jwnelson/HABEXpico/Hardware/HABEXpico8-A/HABEXpico8_BOM.xlsx

Qty | Value | Device | Package | Parts | Description | MANUFACTURER_PART_NUMBER | Digikey PN
1 | 22pF | CAPACITOR_0603_L | RESC0603_L | C0 | Generic chip capacitor | GRM1885C1H220JA01D | 490-1411-1-ND
1 | TV1030-3R0106-R | TV1030-3R0106-R | 5.0MM-SUPERCAP | C1 | 10F Supercapacitor | TV1030-3R0106-R | 283-4668-ND
9 | 0.1uF | 0.1UF-0603-25V-5% | 603 | C4, C8, C11, C12, C13, C16, C23, C24, C27 | 0.1¬µF ceramic capacitors | GCM188R71C104KA37D | 490-4774-1-ND
3 | 1.0uF | 1.0UF-0603-16V-10% | 603 | C14, C15, C19 | 1¬µF ceramic capacitors | CGA3E1X7R1C105K080AC | 445-12539-1-ND
1 | 2.2uF | 2.2UF-0603-10V-20% | 603 | C2 | 2.2¬µF ceramic capacitors | CL10B225KP8NNNC | 1276-1134-1-ND
2 | 10nF | 10NF-0603-50V-10% | 603 | C20, C26 | 0.01uF/10nF/10,000pF ceramic capacitors | GCM188R72A103KA37D | 490-4781-1-ND
2 | 10uF | 10UF-0603-6.3V-20% | 603 | C21, C25 | 10.0¬µF ceramic capacitors | C1608X7S0J106M080AC | 445-9104-1-ND
1 | 10uF | 10UF-0805-10V-10% | 805 | C22 | 10.0¬µF ceramic capacitors | GRM21BC71E106KE11L | 490-10496-1-ND
2 | 10pF | 10PF-0603-50V-5% | 603 | C28, C29 | 10pF ceramic capacitors | 06035A100JAT2A | 478-1163-1-ND
1 | 4.7uF | 4.7UF0603 | 603 | C3 | 4.7¬µF ceramic capacitors | C1608X7S1A475K080AC | 445-14258-1-ND
3 | 22uF | 22UF-0805-6.3V-20% | 805 | C5, C6, C7 | 22¬µF ceramic capacitors | GRM21BD71A226ME44L | 490-9959-1-ND
4 | 6pF | C-EUC0603 | 603 | C9, C10, C17, C18 | CAPACITOR, European symbol | GCM1885C1H6R0DA16D | 490-13303-1-ND
1 | 4.7pF | CAPACITOR_0603_L | 603 | CM | Generic chip capacitor | 06035A4R7BAT2A | 478-10076-1-ND
1 | 7.5pF | CAPACITOR_0603_L | 603 | CM2 | Generic chip capacitor | 06032U7R5CAT2A | 478-3841-1-ND
2 | USBLC6-2SC6 | USBLC6-2SC6 | SOT23-6L | CR1, CR2 | Zener Diode | USBLC6-2SC6 | 497-5235-1-ND
1 | 10pF | CAPACITOR_0603_L | 603 | CX | Generic chip capacitor | GQM1875C2E100JB12D | 490-6086-1-ND
1 | ZLLS400 | ZLLS400 | SOD-323 | D1 | SCHOTTKY DIODE, ZLLS400 | ZLLS400TA | ZLLS400TACT-ND
1 |  | SLVU2.8HTG | SOT-23 | D2 | TVS Diode | SLVU2.8HTG | F4207CT-ND
1 | RED | LED-RED0603 | LED-0603 | D3 | Red SMD LED | LTST-C191KRKT | 160-1447-1-ND
1 | GREEN | LED-GREEN0603 | LED-0603 | D4 | Green SMD LED | LTST-C191KGKT | 160-1446-1-ND
1 |  | LT1763CS8-3.3 | SOIC8 | IC1 | 500mA, Low Noise, LDO Micropower Regulators | LT1129CS8-3.3#PBF | LT1129CS8-3.3#PBF-ND
1 |  | CONN_05X2SHD | 2X5-SHROUDED | J1 | Multi connection point. Often used as Generic Header-pin footprint for 0.1 inch spaced/style header connections | 702461004 | WM3478-ND
1 |  | USB_AB_SMT | USB-AB-MICRO-SMD | J2 | USB Type AB Micro Connector | 10104111-0001LF | 609-4053-1-ND
7 |  | JUMPER-2PTH | 1X02 | JP1, JP2, JP3, JP10, JP11, JP12, JP13 | Jumper | 77311-118-02LF | 609-4434-ND
12 |  | JUMPER-3PTH | 1X03 | JP6, JP7, JP8, JP9, JP14, JP15, JP16, JP17, JP18, JP19, JP20, JP21 |  | 68000-103HLF | 609-3461-ND
1 | 56nH | INDUCTOR_0603_L | RESC0603_L | L0 | Generic chip inductor | B82496C3560J000 | 495-2033-1-ND
1 | 10uH | INDUCTOR-1210 | 1210-INDUCTOR | L1 | Inductor, 1210 Package | 1277AS-H-100M=P2 | 490-10589-1-ND
1 | 33nH/¬±5%/500mA | INDUCTOR-0603-33NH | 603 | L2 | Inductors | PE-0603CD330JTT | 553-1023-2-ND
1 | 470nH | INDUCTOR_0603_L | RESC0603_L | LC | Generic chip inductor | MLZ1608DR47DT000 | 445-6388-1-ND
1 | 12nH | INDUCTOR_0603_L | RESC0603_L | LM | Generic chip inductor | HK160812NJ-T | 587-1546-1-ND
1 | 140nH | INDUCTOR_0603_L | RESC0603_L | LX | Generic chip inductor | HK1608R15J-T | 587-1559-1-ND
3 |  | CONN_08";1X08" | 1X08 | J3, J4, J5 | Genertic header pins | 68001-108HLF | 609-3273-ND
1 | 2.5A/30V | MOSFET-PCHANNELDMG2307L | SOT23-3 | Q1 | Generic PMOSFET | SSM3J334R,LF | SSM3J334RLFCT-ND
5 | 1M | RESISTOR0603 | 603 | R1, R2, R3, R9, R10 | Generic Resistor Package | RC0603FR-071ML | 311-1.00MHRCT-ND
1 | 10 | 10OHM-1206-1/4W-1% | 1206 | R11 | 10Œ© resistor | RT1206BRD0710RL | YAG2330CT-ND
2 | 5.1k | RESISTOR0604 | 603 | R14, R15 | Generic Resistor Package | RR0816P-512-D | RR08P5.1KDCT-ND
2 | 300 | 300OHM-0603-1/10W-1% | 603 | R17, R18 | 300Œ© resistor | RR0816P-301-D | RR08P300DCT-ND
3 | 10k | 10KOHM-0603-1/10W-1% | 603 | R4, R12, R19 | 10kŒ© resistor | RR0816P-103-D | RR08P10.0KDCT-ND
1 | 100 | 100OHM-0603-1/10W-1% | 603 | R5 | 100Œ© resistor | RR0816P-101-D | RR08P100DCT-ND
4 | 27 | 27OHM-0603-1/10W-1% | 603 | R6, R7, R13, R16 | 27Œ© resistor | RR0816Q-270-D | RR08Q27DCT-ND
3 | 100k | 100KOHM-0603-1/10W-1% | 603 | R8, R20, R21 | 100kŒ© resistor | RR0816P-104-D | RR08P100KDCT-ND
2 | KXOB22-04X3 | KXOB22-04X3 | KX0B22 | SC1, SC2 | IXYS Solar Cell | KXOB22-04X3F | KXOB22-04X3F-ND
2 | SKQGADE010 | SMD-BUTTON(4P-5.2X5.2X1.5MM-SKQGADE010)-SKQGADE010 | SW4-SMD-5.2X5.2X1.5MM | SW1, SW2 | 311020017 | RS-187R05A2-DS MT RT | CKN10361CT-ND
1 | LTC3106 | LTC3106 | UDC20QFN | U1 | LTC Series | LTC3106EUDC#PBF | LTC3106EUDC#PBF-ND
1 | EVA-8MQ | EVA-8MQ | EVA-8MQ | U2 | u-blox EVA GNSS module | EVA-M8Q-0 | 672-1000-1-ND
1 | STM32L011G4 | STM32L011G4 | UFQFPN28 | U3 | STM32L0 Series | STM32L011G4U6 | 497-17479-ND
1 | SI4464 | SI4464 | QFN20+GNDPAD | U4 | SI Labs | SI4464-B1B-FM | 336-2472-5-ND
1 | USB-C_R/A_HYBRID_RCPT | USB-C_R/A_HYBRID | USB-C_R/A_HYBRID_RCPT | U5 | USB-C Right Angle Hybrid Receptacle | 12401548E4#2A/BKN
1 | FT232RL | FT232RLSSOP | SSOP28DB | U6 | FT232RL USB UART | FT232RL-REEL | 768-1007-1-ND
1 | 3.3V | V_REG_AP2112K-3.3V | SOT23-5 | U7 | AP2112 - 600mA CMOS LDO Regulator w/ Enable | AP2112K-3.3TRG1 | AP2112K-3.3TRG1DICT-ND
5 |  | BU-SMA-V | BU-SMA-V | X1, X2, X3, X4, X9 | FEMALE SMA CONNECTOR | 5-1814400-1 | A97593-ND
1 | JTI_ANTENNA-1575AT43A40 | JTI_ANTENNA-1575AT43A40 | JTI_ANTENNA-1575AT43A40 | X5 | GPS Antenna - SMD | 1575AT43A0040E | 712-1003-1-ND
1 | C-GRID-04-70553 | C-GRID-04-70553 | 70553-04 | X6 | CONNECTOR | 705530003 | WM4902-ND
1 | C-GRID-02-70553 | C-GRID-02-70553 | 70553-02 | X7 | CONNECTOR | 705530001 | WM4900-ND
1 | 30MHZ 402F3001XIAR | CRYSTALS-GND-LID-IQXC-42 | 2.0X1.6-4-PAD | X8 | CRYSTALS WITH CAN GROUNDED | LFXTAL059596REEL | 1923-1595-1-ND
2 | 32.768kHz | CRYSTAL-32.768KHZSMD-3.2X1.5 | CRYSTAL-SMD-3.2X1.5MM | Y1, Y2 | 32.768kHz Crystal | ABS07-120-32.768KHZ-T | 535-11937-1-ND
