jwnelson/HABEXpico/Hardware/HABEXpico8-B/HABEXpico8-B.kicad_pcb

## KiCad design schematic/kicad/PRESENStick.sch


Parts:
B1: Buzzer
BT1: Battery
C1: 100uF
M1: Motor
Q1: 2SK4017
R1: 330
SW1: SW_PREV
SW2: SW_SELECT
SW3: SW_NEXT
U1: I2C_OLED
U2: M-05720
U3: GR-CITRUS
U4: RN42

Connections:
+3.3V: C1.1, U1.1 (VCC), U2.3 (OUT), U3.21 (3.3V), U4.11 (VDD)
CL: U1.3 (SCL), U3.4 (CL)
DA: U1.4 (SDA), U3.3 (DA)
GND: B1.~, BT1.2, C1.2, Q1.3 (S), SW1.1, SW2.1, SW3.1, U1.2 (GND), U2.2 (GND), U2.7 (GND), U3.23 (GND), U4.12 (GND)
unnamed: B1.~, U3.20 (17)
unnamed: BT1.1, M1.~, U2.8 (IN)
unnamed: M1.~, Q1.2 (D)
unnamed: Q1.1 (G), R1.1
unnamed: SW1.2, U3.13 (10)
unnamed: SW2.2, U3.14 (11)
unnamed: SW3.2, U3.15 (12)
unnamed: U3.1 (RX), U4.14 (UART_TX)
unnamed: U3.2 (TX), U4.13 (UART_RX)
PIN_MOTOR: R1.2, U3.19 (16)
