jwnelson/HABEXpico/Hardware/HABEXpico8-A/HABEXpico8.brd

## EAGLE design Hardware/HABEXpico8-A/HABEXpico8.brd (2020-05-06)

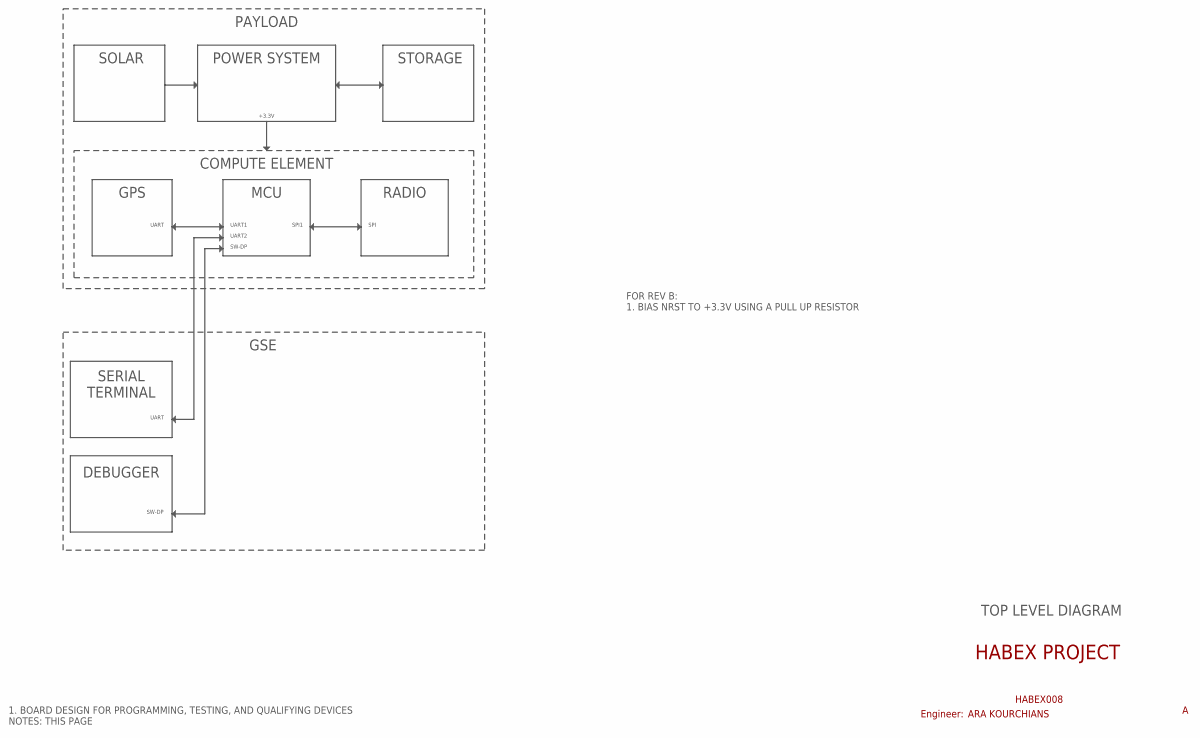
[picture p2: schematic HABEXpico8.sch, sheet 1]

Notes on the sheet:
1. BOARD DESIGN FOR PROGRAMMING, TESTING, AND QUALIFYING DEVICES NOTES: THIS PAGE
HABEX PROJECT
HABEX008
RADIO
MCU
GPS
UART
UART1
SPI1
SPI
ARA KOURCHIANS
Engineer:
TOP LEVEL DIAGRAM
SERIAL TERMINAL
COMPUTE ELEMENT
POWER SYSTEM
+3.3V
SOLAR
STORAGE
UART2
PAYLOAD
DEBUGGER
SW-DP
GSE
FOR REV B: 1. BIAS NRST TO +3.3V USING A PULL UP RESISTOR

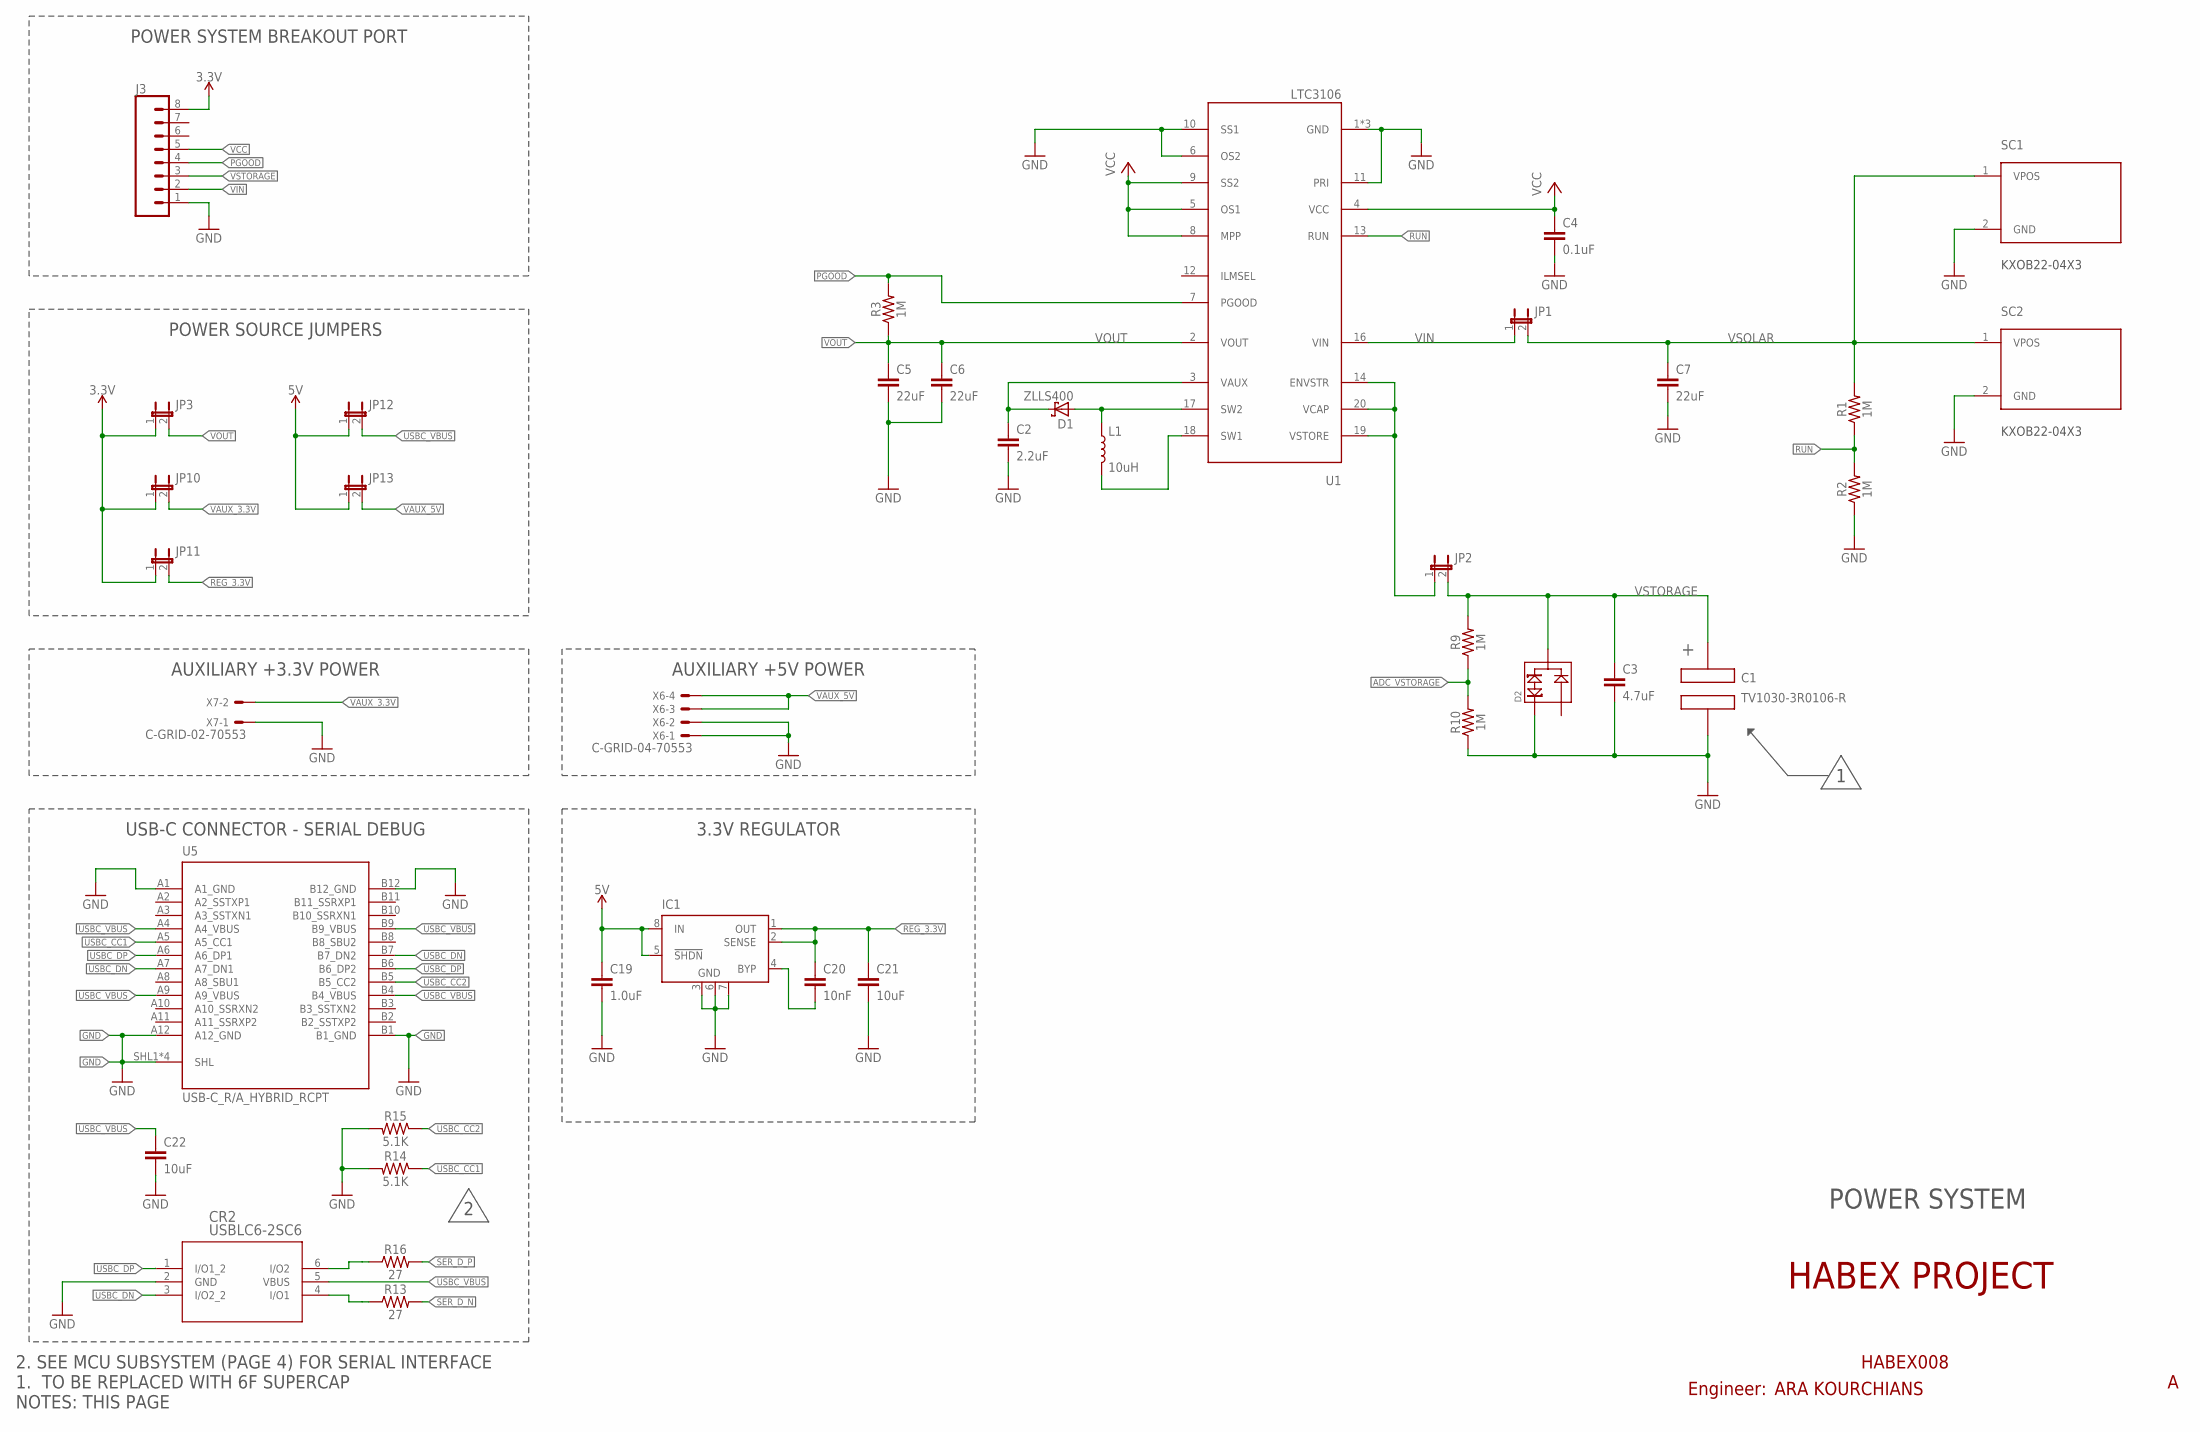
[picture p3: schematic HABEXpico8.sch, sheet 2]

Parts:
C1: TV1030-3R0106-R; 5.0MM-SUPERCAP
C2: 2.2uF; 0603
C3: 4.7uF; 0603
C4: 0.1uF; 0603
C5, C6, C7: 22uF; 0805
C19: 1.0uF; 0603
C20: 10nF; 0603
C21: 10uF; 0603
C22: 10uF; 0805
CR2: USBLC6-2SC6; SOT23-6L
D1: ZLLS400; SOD-323
D2: SLVU2.8HTG; SOT-23
IC1: LT1763CS8-3.3; SOIC8
J3: CONN_08"; 1X08
JP1, JP2, JP3, JP10, JP11, JP12, JP13: JUMPER-2PTH; 1X02
L1: 10uH; 1210-INDUCTOR
R1, R2, R3, R9, R10: 1M; 0603
R13, R16: 27; 0603
R14, R15: 5.1K; 0603
SC1, SC2: KXOB22-04X3; KX0B22
U1: LTC3106; UDC20QFN
U5: USB-C_R/A_HYBRID_RCPT
X6: C-GRID-04-70553; 70553-04
X7: C-GRID-02-70553; 70553-02

Connections:
2: D2.2
3.3V: J3.8, JP3.1, JP10.1, JP11.1; also elsewhere on the board
5V: C19.1, IC1.5 (!SHDN), IC1.8 (IN), JP12.1, JP13.1; also elsewhere on the board
ADC_VSTORAGE: R9.1, R10.2; also elsewhere on the board
GND: C1.2 (CAP_NEG), C2.2, C3.2, C4.2, C5.2, C6.2, C7.2, C19.2, C21.2, C22.2, CR2.2 (GND), D2.1, IC1.3 (GND), IC1.6 (GND), IC1.7 (GND), J3.1, R2.1, R10.1, R14.2, R15.2, SC1.2 (GND), SC2.2 (GND), U1.1 (GND), U1.6 (OS2), U1.10 (SS1), U1.11 (PRI), U1.15 (GND), U1.21 (GND), U5.A1 (A1_GND), U5.A12 (A12_GND), U5.B1 (B1_GND), U5.B12 (B12_GND), U5.SHL1 (SHL), U5.SHL2 (SHL), U5.SHL3 (SHL), U5.SHL4 (SHL), X6.1, X6.2, X7.1; also elsewhere on the board
unnamed: D1.A, L1.1, U1.17 (SW2)
unnamed: L1.2, U1.18 (SW1)
unnamed: C2.1, D1.C, U1.3 (VAUX)
unnamed: JP2.1, U1.14 (ENVSTR), U1.19 (VSTORE), U1.20 (VCAP)
unnamed: CR2.6 (I/O2), R16.1
unnamed: CR2.4 (I/O1), R13.1
unnamed: C20.2, IC1.4 (BYP)
PGOOD: J3.4, R3.2, U1.7 (PGOOD)
REG_3.3V: C20.1, C21.1, IC1.1 (OUT), IC1.2 (SENSE), JP11.2
RUN: R1.1, R2.2, U1.13 (RUN)
SER_D_N: R13.2; also elsewhere on the board
SER_D_P: R16.2; also elsewhere on the board
USBC_CC1: R14.1, U5.A5 (A5_CC1)
USBC_CC2: R15.1, U5.B5 (B5_CC2)
USBC_DN: CR2.3 (I/O2_2), U5.A7 (A7_DN1), U5.B7 (B7_DN2)
USBC_DP: CR2.1 (I/O1_2), U5.A6 (A6_DP1), U5.B6 (B6_DP2)
USBC_VBUS: C22.1, CR2.5 (VBUS), JP12.2, U5.A4 (A4_VBUS), U5.A9 (A9_VBUS), U5.B4 (B4_VBUS), U5.B9 (B9_VBUS)
VAUX_3.3V: JP10.2, X7.2
VAUX_5V: JP13.2, X6.3, X6.4
VCC: C4.1, J3.5, U1.4 (VCC), U1.5 (OS1), U1.8 (MPP), U1.9 (SS2)
VIN: J3.2, JP1.1, U1.16 (VIN)
VOUT: C5.1, C6.1, JP3.2, R3.1, U1.2 (VOUT)
VSOLAR: C7.1, JP1.2, R1.2, SC1.1 (VPOS), SC2.1 (VPOS)
VSTORAGE: C1.1 (CAP_POS), C3.1, D2.3, J3.3, JP2.2, R9.2

Notes on the sheet:
2. SEE MCU SUBSYSTEM (PAGE 4) FOR SERIAL INTERFACE 1. TO BE REPLACED WITH 6F SUPERCAP NOTES: THIS PAGE
HABEX PROJECT
HABEX008
POWER SYSTEM BREAKOUT PORT
ARA KOURCHIANS
Engineer:
POWER SYSTEM
POWER SOURCE JUMPERS
AUXILIARY +3.3V POWER
USB-C CONNECTOR - SERIAL DEBUG
3.3V REGULATOR
AUXILIARY +5V POWER

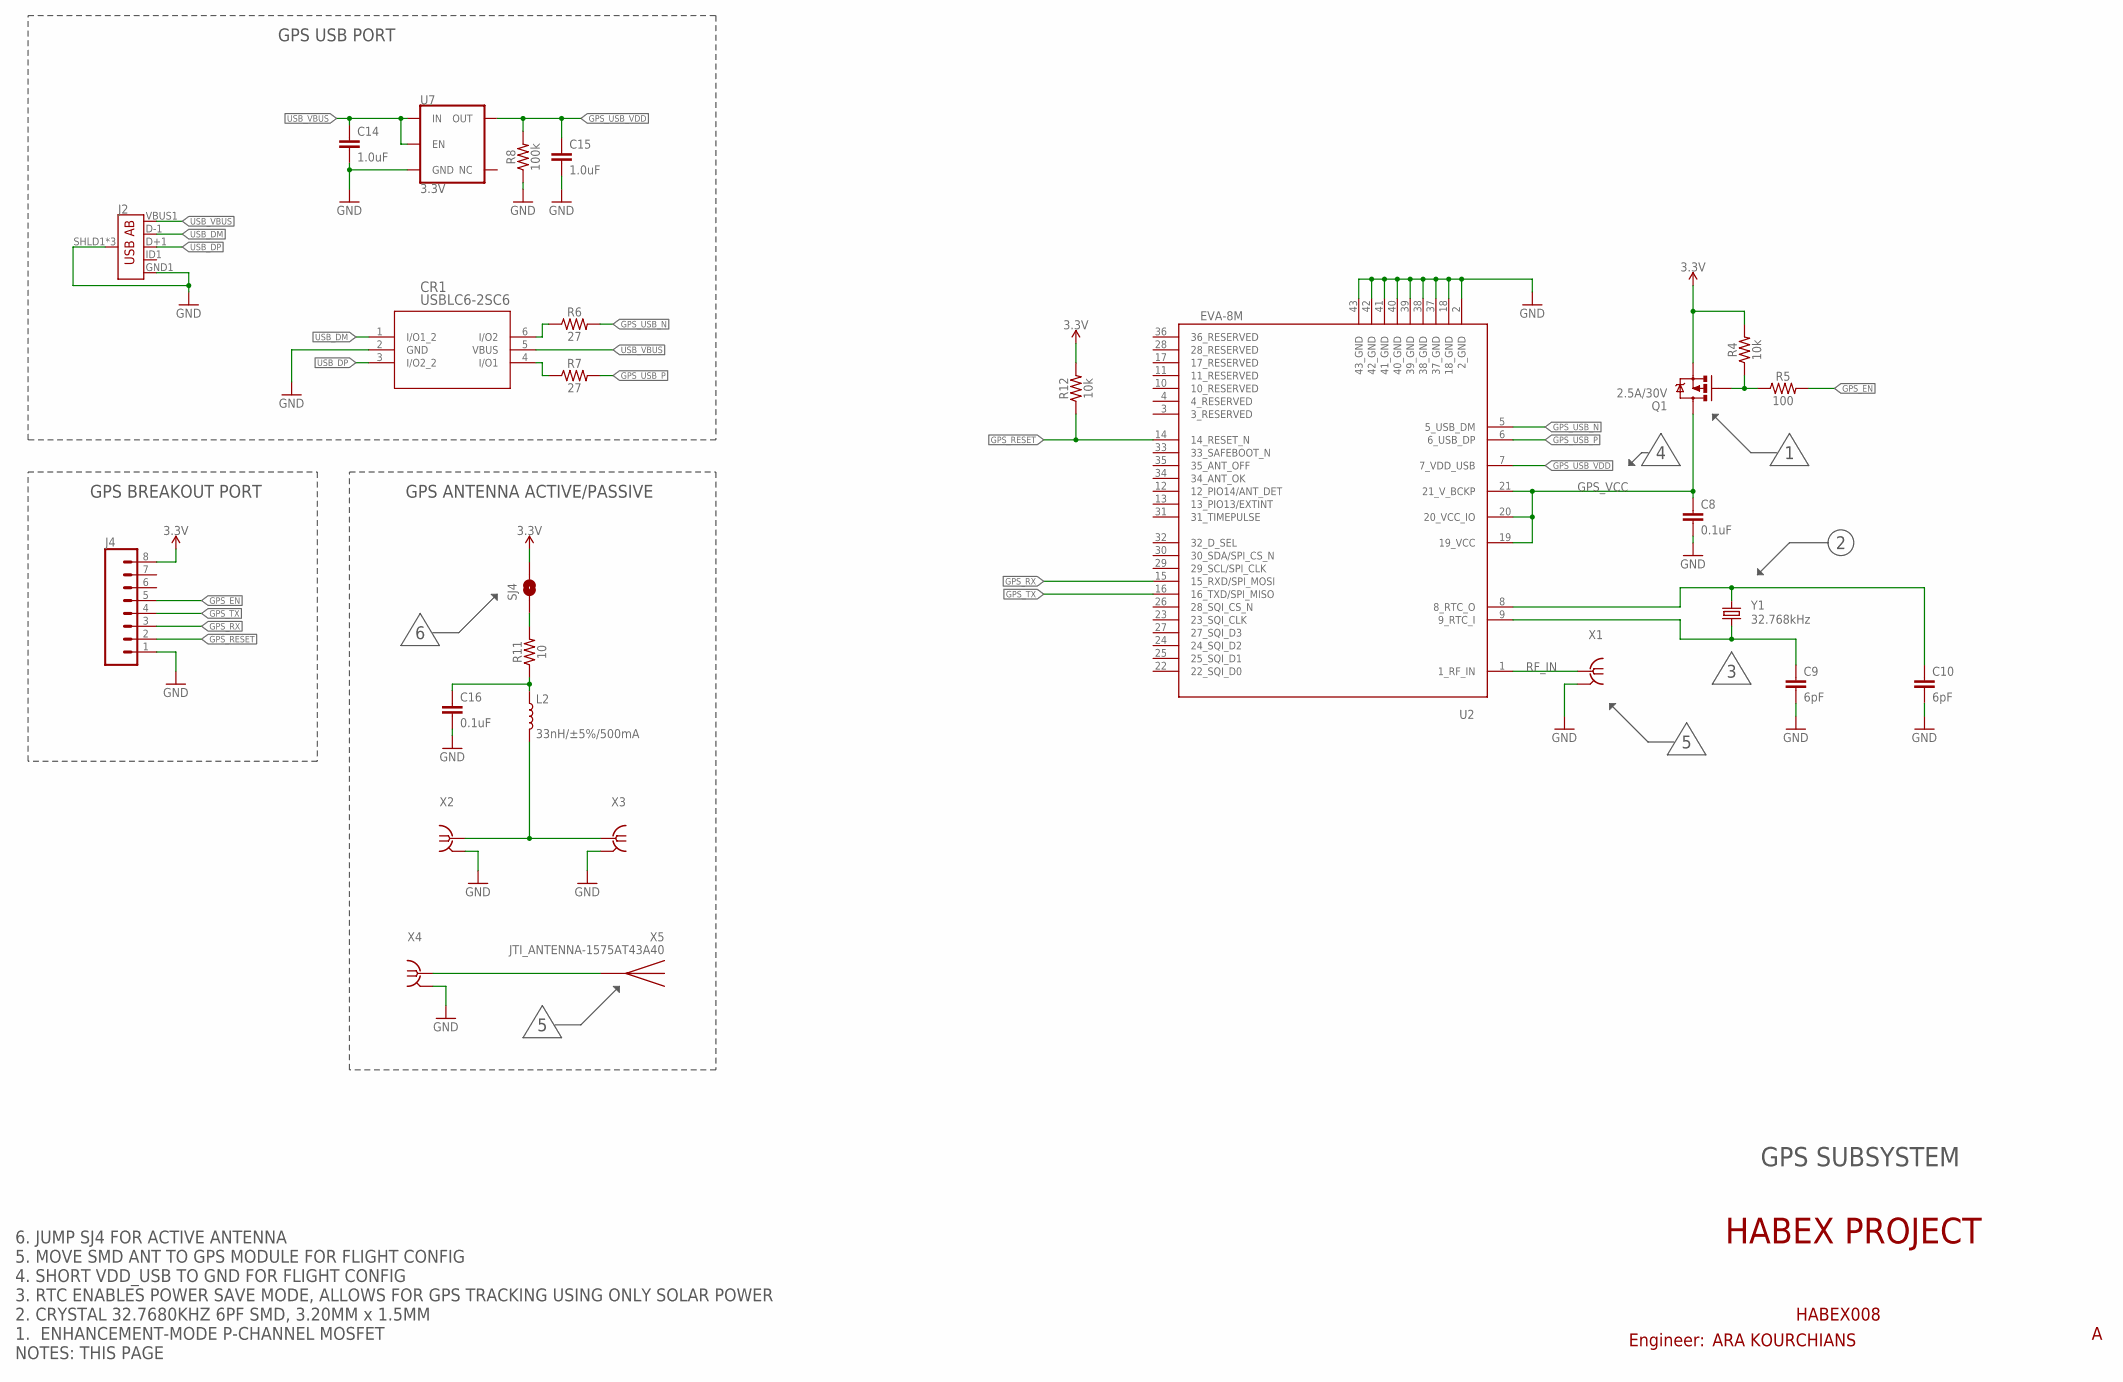
[picture p4: schematic HABEXpico8.sch, sheet 3]

Parts:
C8, C16: 0.1uF; 0603
C9, C10: 6pF; C0603
C14, C15: 1.0uF; 0603
CR1: USBLC6-2SC6; SOT23-6L
J2: USB_AB_SMT; USB-AB-MICRO-SMD
J4: CONN_08"; 1X08
L2: 33nH/±5%/500mA; 0603
Q1: 2.5A/30V; SOT23-3
R4, R12: 10k; 0603
R5: 100; 0603
R6, R7: 27; 0603
R8: 100k; 0603
R11: 10; 1206
SJ4: SOLDERJUMPERNO; SJ_2S-NO
U2: EVA-8M
U7: 3.3V; SOT23-5
X1, X2, X3, X4: BU-SMA-V
X5: JTI_ANTENNA-1575AT43A40
Y1: 32.768kHz; CRYSTAL-SMD-3.2X1.5MM

Connections:
3.3V: J4.8, Q1.2 (S), R4.2, R12.2, SJ4.2; also elsewhere on the board
GND: C8.2, C9.2, C10.2, C14.2, C15.2, C16.2, CR1.2 (GND), J2.GND1 (GND), J2.SHLD1 (SHIELD), J2.SHLD2 (SHIELD), J2.SHLD3 (SHIELD), J4.1, R8.1, U2.2 (2_GND), U2.18 (18_GND), U2.37 (37_GND), U2.38 (38_GND), U2.39 (39_GND), U2.40 (40_GND), U2.41 (41_GND), U2.42 (42_GND), U2.43 (43_GND), U7.2 (GND), X1.2, X1.3 (2), X1.4 (2), X1.5 (2), X2.2, X2.3 (2), X2.4 (2), X2.5 (2), X3.2, X3.3 (2), X3.4 (2), X3.5 (2), X4.2, X4.3 (2), X4.4 (2), X4.5 (2); also elsewhere on the board
GPS_EN: J4.5, R5.2; also elsewhere on the board
GPS_RESET: J4.2, R12.1, U2.14 (14_RESET_N)
GPS_RX: J4.3, U2.15 (15_RXD/SPI_MOSI); also elsewhere on the board
GPS_TX: J4.4, U2.16 (16_TXD/SPI_MISO); also elsewhere on the board
GPS_USB_N: R6.2, U2.5 (5_USB_DM)
GPS_USB_P: R7.2, U2.6 (6_USB_DP)
GPS_USB_VDD: C15.1, R8.2, U2.7 (7_VDD_USB), U7.5 (OUT)
GPS_VCC: C8.1, Q1.3 (D), U2.19 (19_VCC), U2.20 (20_VCC_IO), U2.21 (21_V_BCKP)
unnamed: X4.1, X5.FEED
unnamed: Q1.1 (G), R4.1, R5.1
unnamed: C9.1, U2.9 (9_RTC_I), Y1.P$1 (1)
unnamed: C10.1, U2.8 (8_RTC_O), Y1.P$2 (2)
unnamed: CR1.6 (I/O2), R6.1
unnamed: CR1.4 (I/O1), R7.1
unnamed: C16.1, L2.1, R11.1
unnamed: L2.2, X2.1, X3.1
unnamed: R11.2, SJ4.1
RF_IN: U2.1 (1_RF_IN), X1.1
USB_DM: CR1.1 (I/O1_2), J2.D-1 (D-)
USB_DP: CR1.3 (I/O2_2), J2.D+1 (D+)
USB_VBUS: C14.1, CR1.5 (VBUS), J2.VBUS1 (VBUS), U7.1 (IN), U7.3 (EN)

Notes on the sheet:
6. JUMP SJ4 FOR ACTIVE ANTENNA 5. MOVE SMD ANT TO GPS MODULE FOR FLIGHT CONFIG 4. SHORT VDD_USB TO GND FOR FLIGHT CONFIG 3. RTC ENABLES POWER SAVE MODE, ALLOWS FOR GPS TRACKING USING ONLY SOLAR POWER 2. CRYSTAL 32.7680KHZ 6PF SMD, 3.20MM x 1.5MM 1. ENHANCEMENT-MODE P-CHANNEL MOSFET NOTES: THIS PAGE
HABEX PROJECT
HABEX008
GPS USB PORT
ARA KOURCHIANS
Engineer:
GPS BREAKOUT PORT
GPS ANTENNA ACTIVE/PASSIVE
GPS SUBSYSTEM

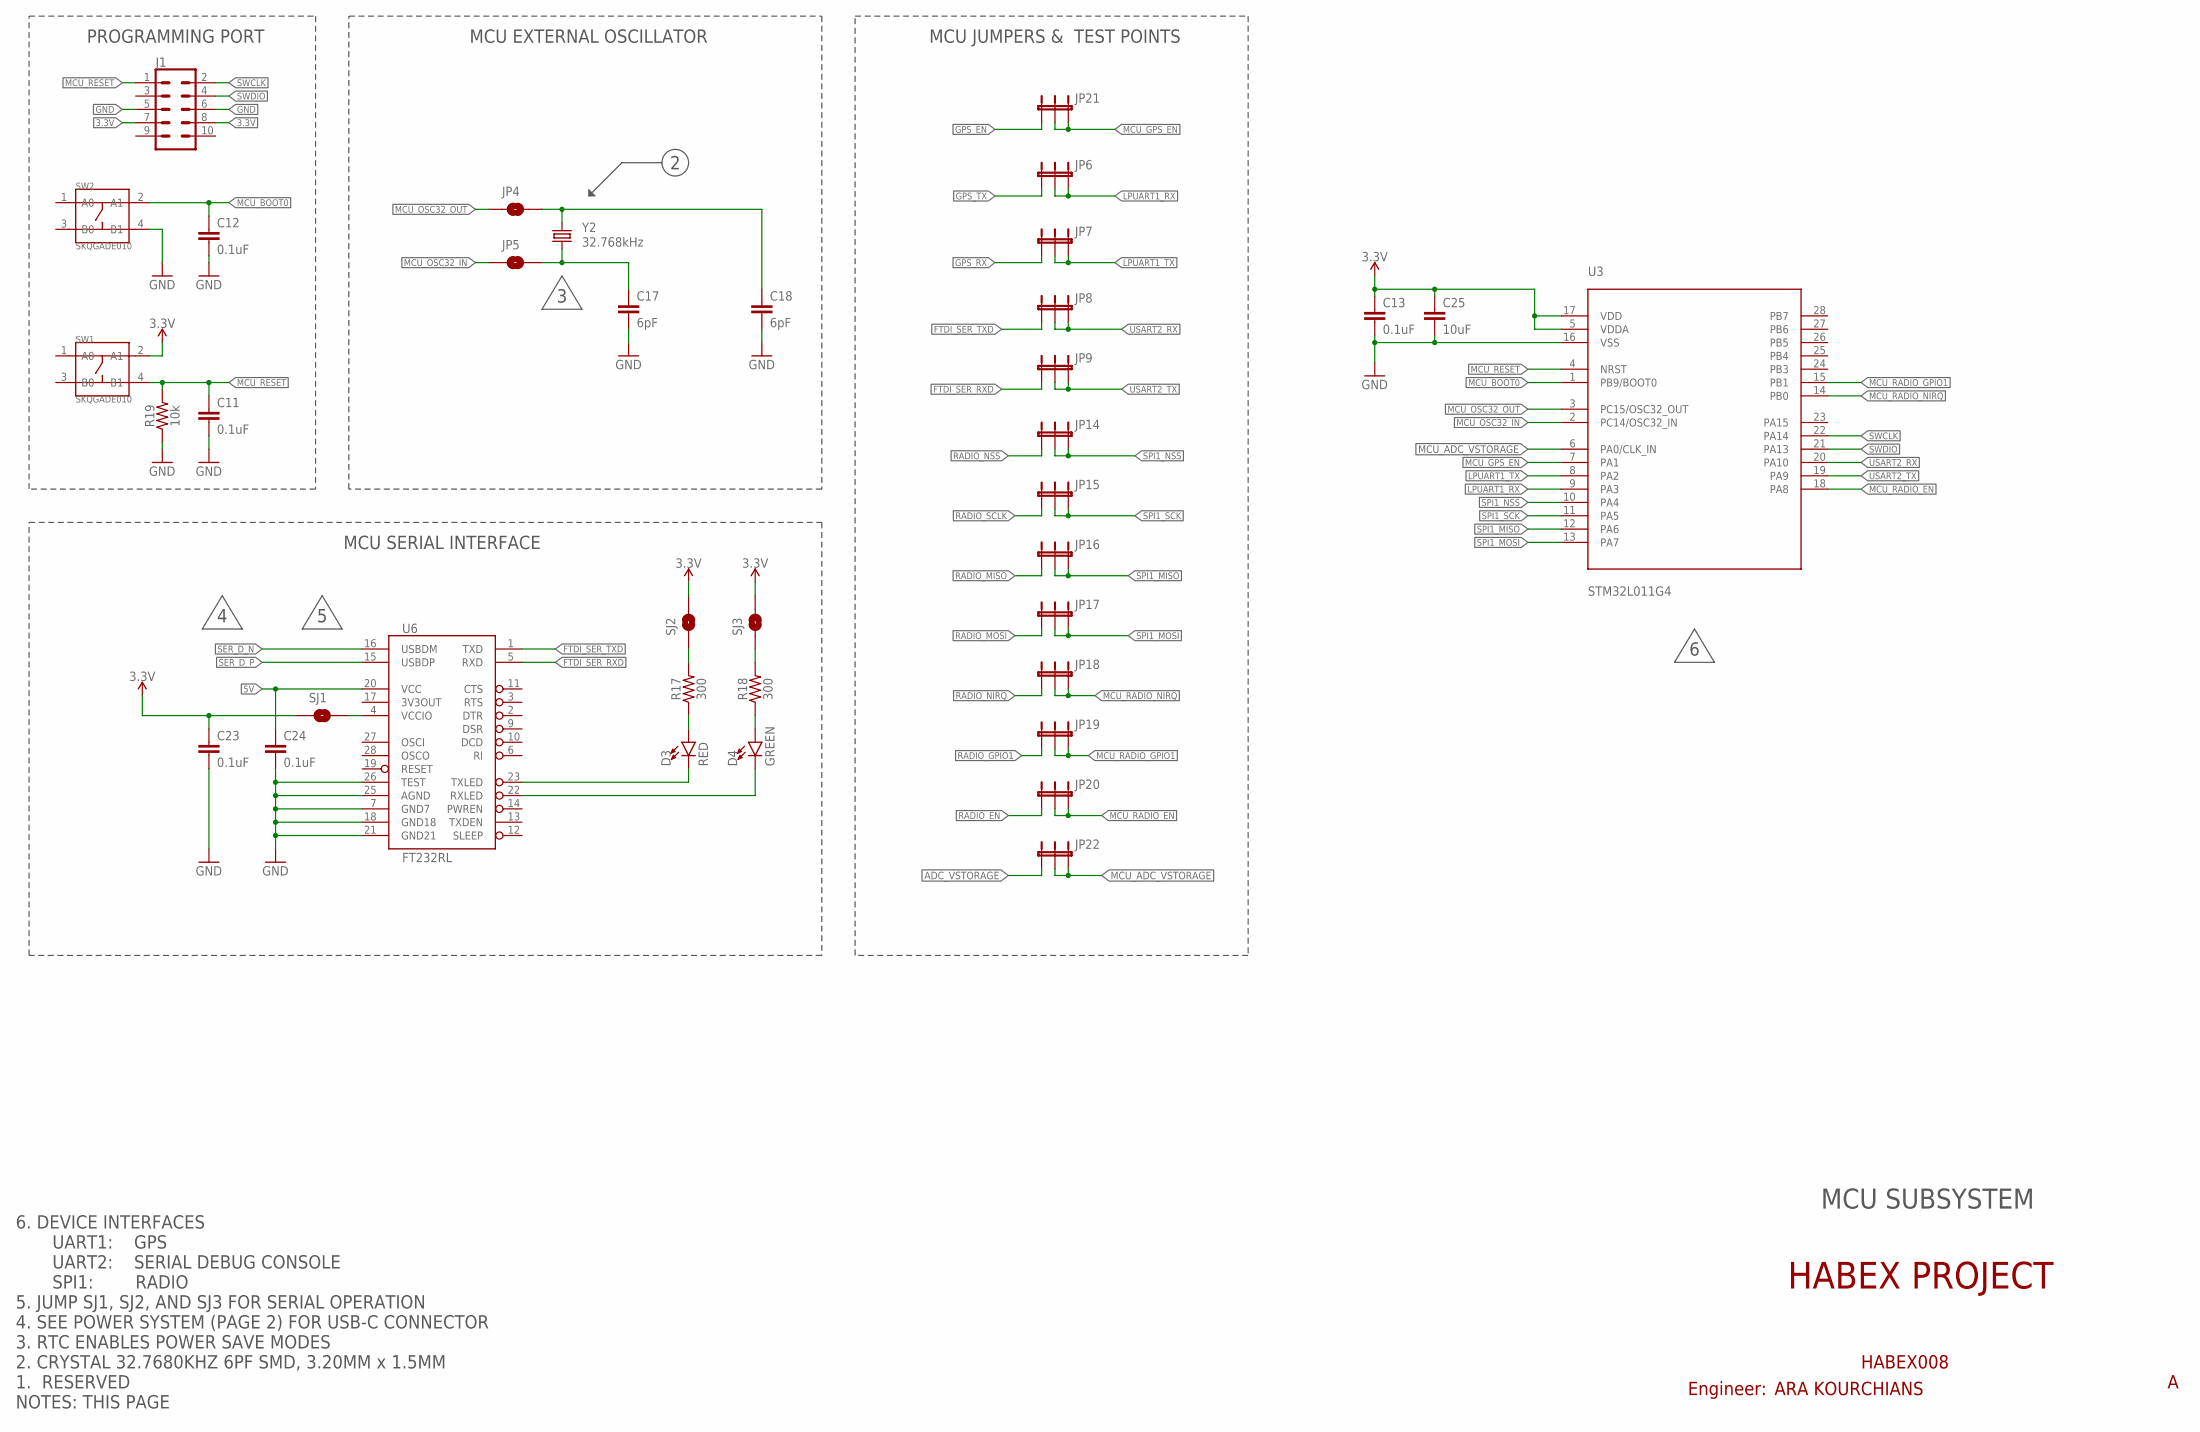
[picture p5: schematic HABEXpico8.sch, sheet 4]

Parts:
C11, C12, C13, C23, C24: 0.1uF; 0603
C17, C18: 6pF; C0603
C25: 10uF; 0603
D3: RED; LED-0603
D4: GREEN; LED-0603
J1: CONN_05X2SHD; 2X5-SHROUDED
JP4, JP5: JUMPER-SMT_2_NO_SILK; SMT-JUMPER_2_NO_SILK
JP6, JP7, JP8, JP9, JP14, JP15, JP16, JP17, JP18, JP19, JP20, JP21, JP22: JUMPER-3PTH; 1X03
R17, R18: 300; 0603
R19: 10k; 0603
SJ1, SJ2, SJ3: SOLDERJUMPERNO; SJ_2S-NO
SW1, SW2: SKQGADE010; SW4-SMD-5.2X5.2X1.5MM
U3: STM32L011G4; UFQFPN28
U6: FT232RL; SSOP28DB
Y2: 32.768kHz; CRYSTAL-SMD-3.2X1.5MM

Connections:
3.3V: C13.1, C23.1, C25.1, J1.7, J1.8, SJ1.1, SJ2.2, SJ3.2, SW1.2 (A1), U3.5 (VDDA), U3.17 (VDD); also elsewhere on the board
5V: C24.1, U6.20 (VCC); also elsewhere on the board
ADC_VSTORAGE: JP22.1; also elsewhere on the board
FTDI_SER_RXD: JP9.1, U6.5 (RXD)
FTDI_SER_TXD: JP8.1, U6.1 (TXD)
GND: C11.2, C12.2, C13.2, C17.2, C18.2, C23.2, C24.2, C25.2, J1.5, J1.6, R19.1, SW2.4 (B1), U3.16 (VSS), U6.7 (GND7), U6.18 (GND18), U6.21 (GND21), U6.25 (AGND), U6.26 (TEST); also elsewhere on the board
GPS_EN: JP21.1; also elsewhere on the board
GPS_RX: JP7.1; also elsewhere on the board
GPS_TX: JP6.1; also elsewhere on the board
LPUART1_RX: JP6.2, JP6.3, U3.9 (PA3)
LPUART1_TX: JP7.2, JP7.3, U3.8 (PA2)
MCU_ADC_VSTORAGE: JP22.2, JP22.3, U3.6 (PA0/CLK_IN)
MCU_BOOT0: C12.1, SW2.2 (A1), U3.1 (PB9/BOOT0)
MCU_GPS_EN: JP21.2, JP21.3, U3.7 (PA1)
MCU_OSC32_IN: JP5.1, U3.2 (PC14/OSC32_IN)
MCU_OSC32_OUT: JP4.1, U3.3 (PC15/OSC32_OUT)
MCU_RADIO_EN: JP20.2, JP20.3, U3.18 (PA8)
MCU_RADIO_GPIO1: JP19.2, JP19.3, U3.15 (PB1)
MCU_RADIO_NIRQ: JP18.2, JP18.3, U3.14 (PB0)
MCU_RESET: C11.1, J1.1, R19.2, SW1.4 (B1), U3.4 (NRST)
unnamed: C17.1, JP5.2, Y2.P$1 (1)
unnamed: C18.1, JP4.2, Y2.P$2 (2)
unnamed: D3.C, U6.23 (TXLED)
unnamed: D4.C, U6.22 (RXLED)
unnamed: D3.A, R17.1
unnamed: D4.A, R18.1
unnamed: SJ1.2, U6.4 (VCCIO)
unnamed: R17.2, SJ2.1
unnamed: R18.2, SJ3.1
RADIO_EN: JP20.1; also elsewhere on the board
RADIO_GPIO1: JP19.1; also elsewhere on the board
RADIO_MISO: JP16.1; also elsewhere on the board
RADIO_MOSI: JP17.1; also elsewhere on the board
RADIO_NIRQ: JP18.1; also elsewhere on the board
RADIO_NSS: JP14.1; also elsewhere on the board
RADIO_SCLK: JP15.1; also elsewhere on the board
SER_D_N: U6.16 (USBDM); also elsewhere on the board
SER_D_P: U6.15 (USBDP); also elsewhere on the board
SPI1_MISO: JP16.2, JP16.3, U3.12 (PA6)
SPI1_MOSI: JP17.2, JP17.3, U3.13 (PA7)
SPI1_NSS: JP14.2, JP14.3, U3.10 (PA4)
SPI1_SCK: JP15.2, JP15.3, U3.11 (PA5)
SWCLK: J1.2, U3.22 (PA14)
SWDIO: J1.4, U3.21 (PA13)
USART2_RX: JP8.2, JP8.3, U3.20 (PA10)
USART2_TX: JP9.2, JP9.3, U3.19 (PA9)

Notes on the sheet:
PROGRAMMING PORT
HABEX PROJECT
HABEX008
ARA KOURCHIANS
Engineer:
6. DEVICE INTERFACES UART1: GPS UART2: SERIAL DEBUG CONSOLE SPI1: RADIO 5. JUMP SJ1, SJ2, AND SJ3 FOR SERIAL OPERATION 4. SEE POWER SYSTEM (PAGE 2) FOR USB-C CONNECTOR 3. RTC ENABLES POWER SAVE MODES 2. CRYSTAL 32.7680KHZ 6PF SMD, 3.20MM x 1.5MM 1. RESERVED NOTES: THIS PAGE
MCU SUBSYSTEM
MCU SERIAL INTERFACE
MCU EXTERNAL OSCILLATOR
MCU JUMPERS & TEST POINTS

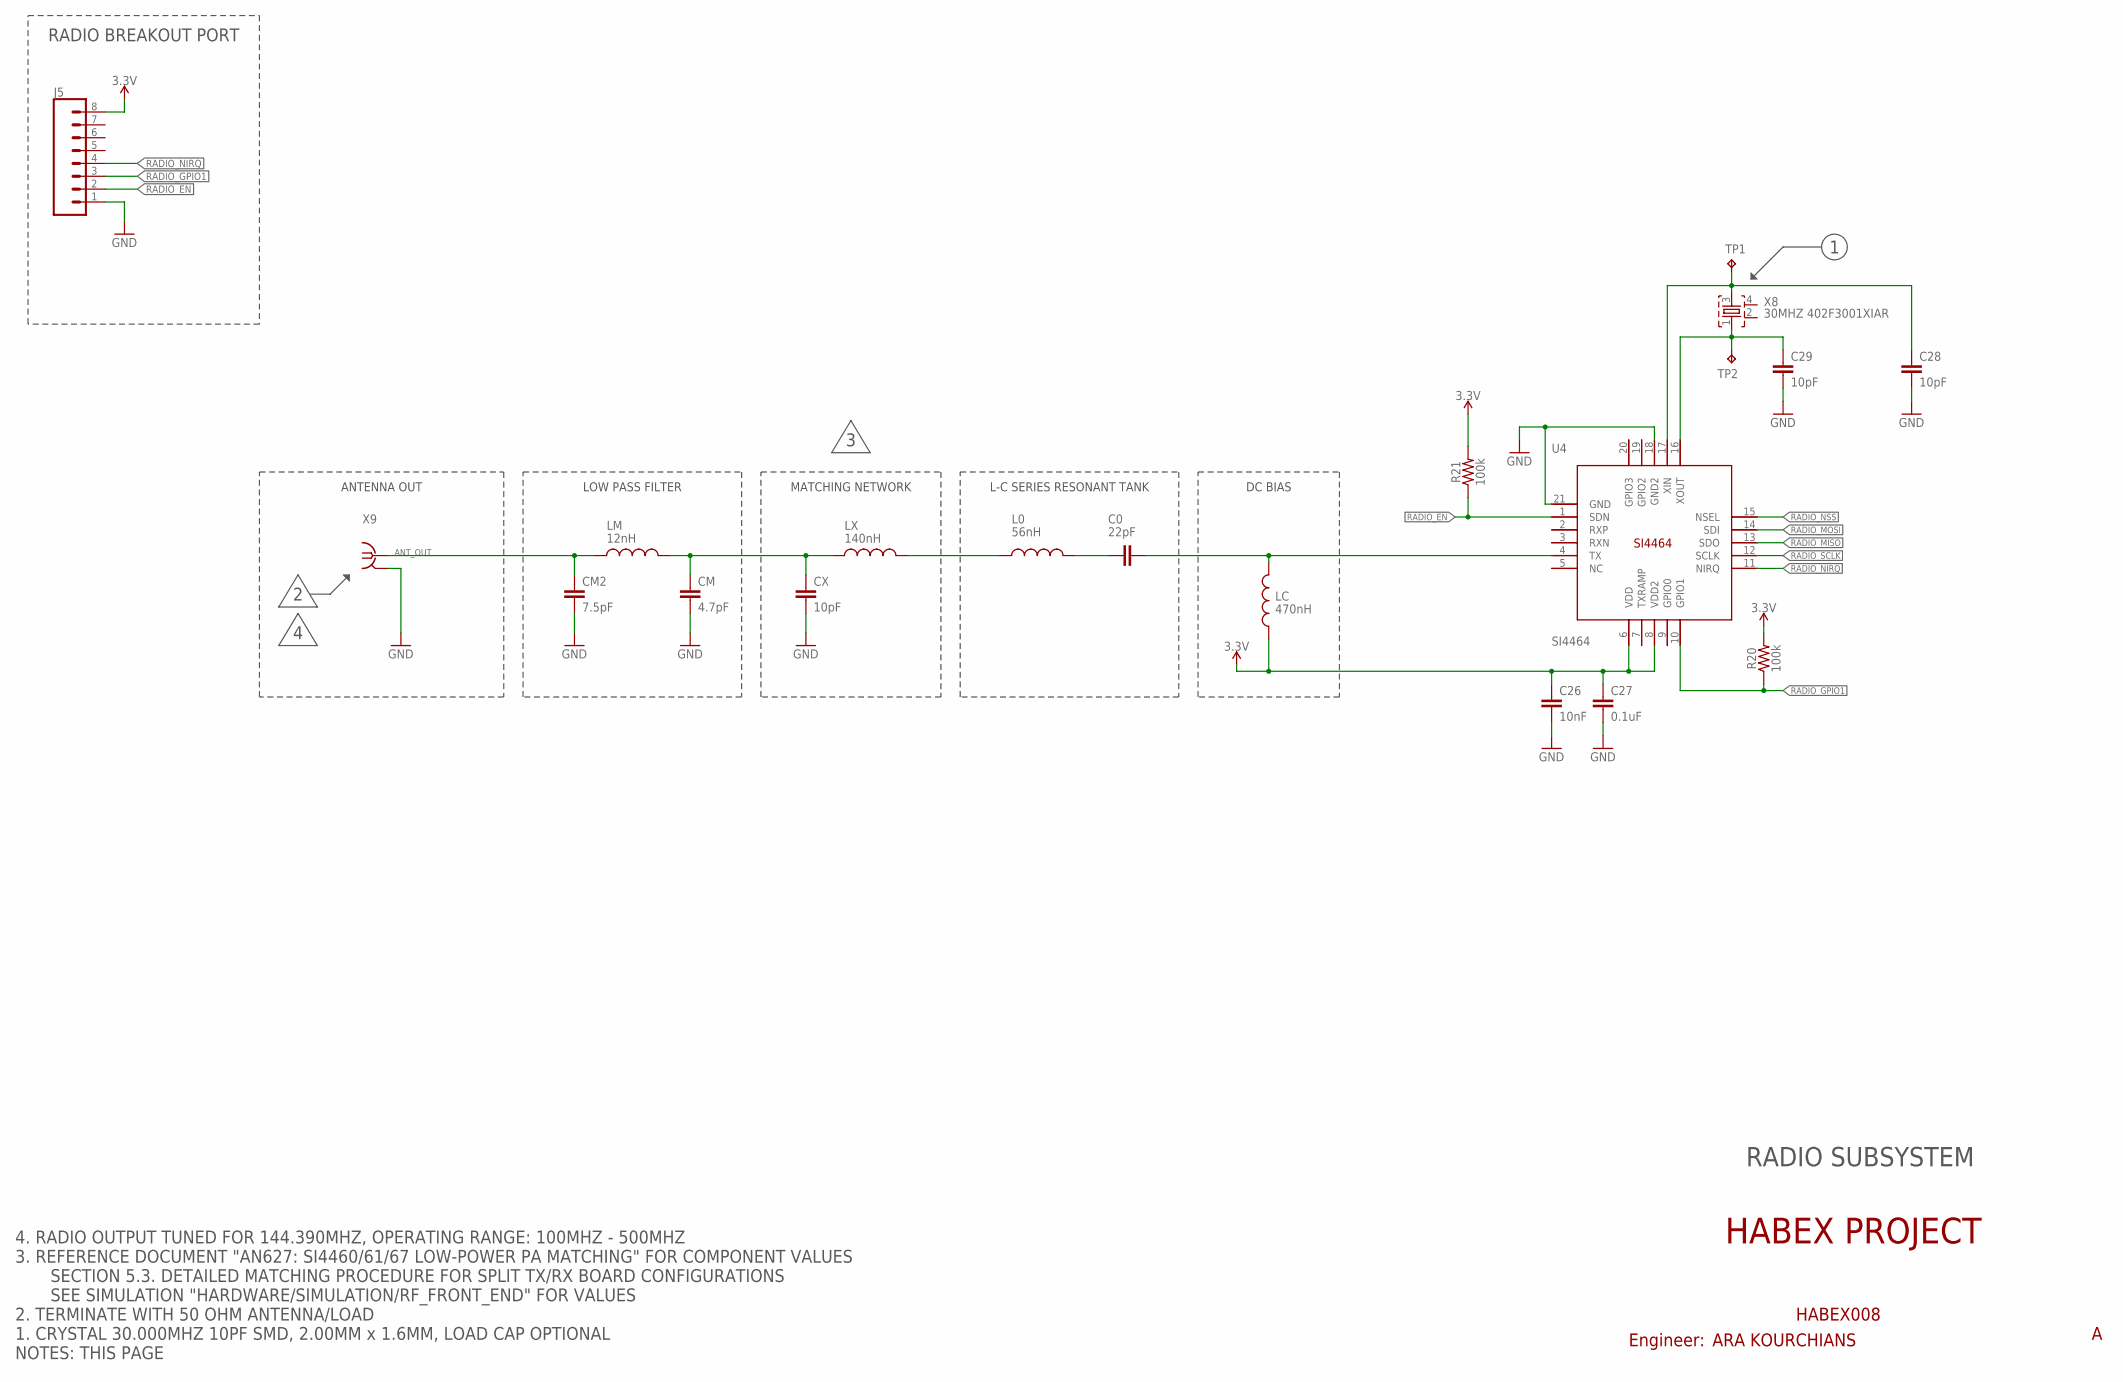
[picture p6: schematic HABEXpico8.sch, sheet 5]

Parts:
C0: 22pF; RESC0603_L
C26: 10nF; 0603
C27: 0.1uF; 0603
C28, C29: 10pF; 0603
CM: 4.7pF; RESC0603_L
CM2: 7.5pF; RESC0603_L
CX: 10pF; RESC0603_L
J5: CONN_08"; 1X08
L0: 56nH; RESC0603_L
LC: 470nH; RESC0603_L
LM: 12nH; RESC0603_L
LX: 140nH; RESC0603_L
R20, R21: 100k; 0603
TP1, TP2: TPPAD1-13; P1-13
U4: SI4464; QFN20+GNDPAD
X8: 30MHZ 402F3001XIAR; 2.0X1.6-4-PAD
X9: BU-SMA-V

Connections:
3.3V: C26.1, C27.1, J5.8, LC.1, R20.2, R21.2, U4.6 (VDD), U4.8 (VDD2); also elsewhere on the board
ANT_OUT: CM2.1, LM.1, X9.1
GND: C26.2, C27.2, C28.2, C29.2, CM.2, CM2.2, CX.2, J5.1, U4.18 (GND2), U4.21 (GND), X9.2, X9.3 (2), X9.4 (2), X9.5 (2); also elsewhere on the board
unnamed: C28.1, TP1.TP, U4.17 (XIN), X8.3
unnamed: C29.1, TP2.TP, U4.16 (XOUT), X8.1
unnamed: C0.1, LC.2, U4.4 (TX)
unnamed: L0.1, LX.2
unnamed: C0.2, L0.2
unnamed: CM.1, CX.1, LM.2, LX.1
RADIO_EN: J5.2, R21.1, U4.1 (SDN); also elsewhere on the board
RADIO_GPIO1: J5.3, R20.1, U4.10 (GPIO1); also elsewhere on the board
RADIO_MISO: U4.13 (SDO); also elsewhere on the board
RADIO_MOSI: U4.14 (SDI); also elsewhere on the board
RADIO_NIRQ: J5.4, U4.11 (NIRQ); also elsewhere on the board
RADIO_NSS: U4.15 (NSEL); also elsewhere on the board
RADIO_SCLK: U4.12 (SCLK); also elsewhere on the board

Notes on the sheet:
HABEX PROJECT
HABEX008
ARA KOURCHIANS
Engineer:
RADIO SUBSYSTEM
4. RADIO OUTPUT TUNED FOR 144.390MHZ, OPERATING RANGE: 100MHZ - 500MHZ 3. REFERENCE DOCUMENT "AN627: SI4460/61/67 LOW-POWER PA MATCHING" FOR COMPONENT VALUES SECTION 5.3. DETAILED MATCHING PROCEDURE FOR SPLIT TX/RX BOARD CONFIGURATIONS SEE SIMULATION "HARDWARE/SIMULATION/RF_FRONT_END" FOR VALUES 2.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
MATCHING NETWORK
LOW PASS FILTER
L-C SERIES RESONANT TANK
DC BIAS
ANTENNA OUT
RADIO BREAKOUT PORT

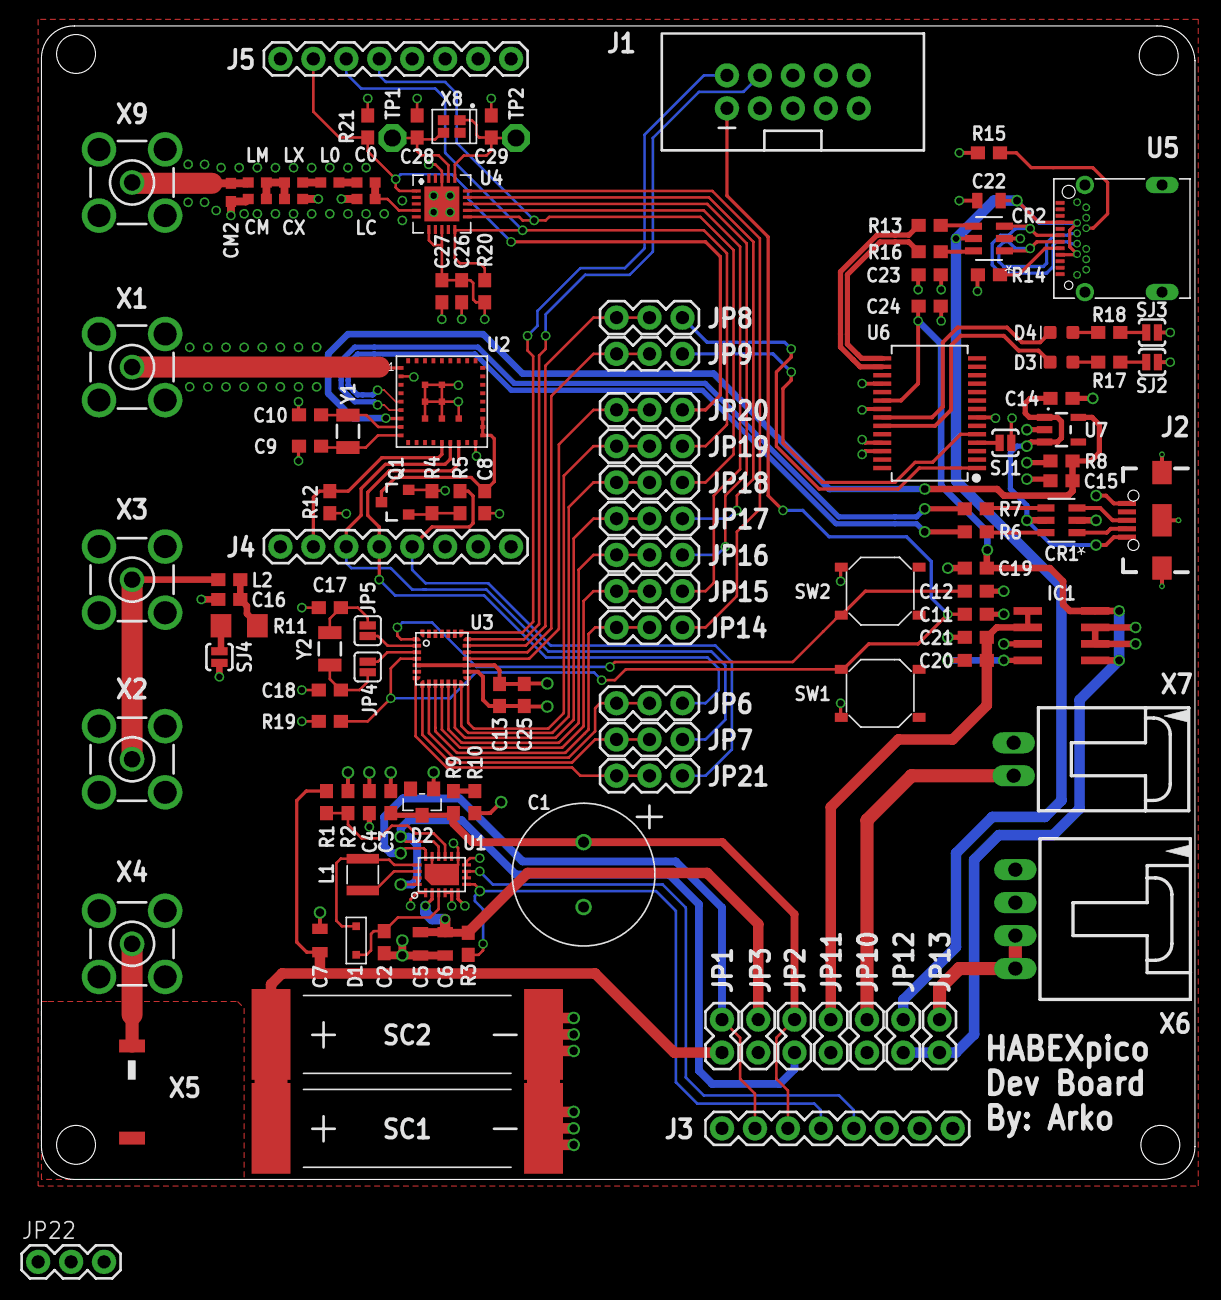
[picture p7: board HABEXpico8.brd from above]

Board: 4 copper layers, 88.9 x 88.9 mm, 123 parts (0 on the bottom side), 93 nets.
